simple-circuit/cocodvi/coco_dvi_sch.png

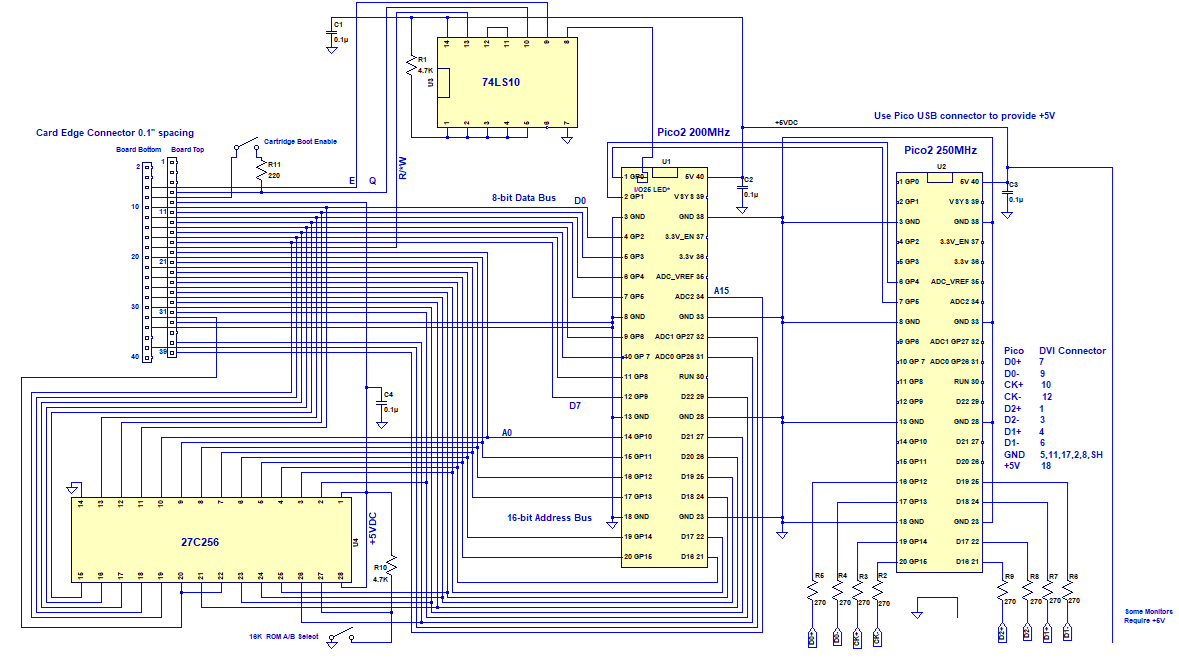
coco_dvi_sch.png
