simple-circuit/cocodvi/pico_hstx_coco_11/matrix.h

//matrix.h Simple-Circuit 2026

/*MIT License

matrix.h Copyright (c) 2026 simple-circuit

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
THE SOFTWARE IS PROVIDED "AS IS", WITHOUT WARRANTY OF ANY KIND, EXPRESS OR
IMPLIED, INCLUDING BUT NOT LIMITED TO THE WARRANTIES OF MERCHANTABILITY,
FITNESS FOR A PARTICULAR PURPOSE AND NONINFRINGEMENT. IN NO EVENT SHALL THE
AUTHORS OR COPYRIGHT HOLDERS BE LIABLE FOR ANY CLAIM, DAMAGES OR OTHER
LIABILITY, WHETHER IN AN ACTION OF CONTRACT, TORT OR OTHERWISE, ARISING FROM,
OUT OF OR IN CONNECTION WITH THE SOFTWARE OR THE USE OR OTHER DEALINGS IN THE
SOFTWARE.
*/ 
//128 ascii character matrix values for a 5x7 pixel display
// SPACE
bc[ 0x20] [ 2 ] = B0000000;
bc[ 0x20] [ 3 ] = B0000000;
bc[ 0x20] [ 4 ] = B0000000;
bc[ 0x20] [ 5 ] = B0000000;
bc[ 0x20] [ 6 ] = B0000000;
bc[ 0x20] [ 7 ] = B0000000;
bc[ 0x20] [ 8 ] = B0000000;
// !
bc[ 0x21] [ 2 ] = B0110000;
bc[ 0x21] [ 3 ] = B0110000;
bc[ 0x21] [ 4 ] = B0110000;
bc[ 0x21] [ 5 ] = B0110000;
bc[ 0x21] [ 6 ] = B0110000;
bc[ 0x21] [ 7 ] = B0000000;
bc[ 0x21] [ 8 ] = B0110000;
// "
bc[ 0x22] [ 2 ] = B0101000;
bc[ 0x22] [ 3 ] = B0101000;
bc[ 0x22] [ 4 ] = B0000000;
bc[ 0x22] [ 5 ] = B0000000;
bc[ 0x22] [ 6 ] = B0000000;
bc[ 0x22] [ 7 ] = B0000000;
bc[ 0x22] [ 8 ] = B0000000;
// #
bc[ 0x23] [ 2 ] = B0000000;
bc[ 0x23] [ 3 ] = B0101000;
bc[ 0x23] [ 4 ] = B1111100;
bc[ 0x23] [ 5 ] = B0101000;
bc[ 0x23] [ 6 ] = B1111100;
bc[ 0x23] [ 7 ] = B0101000;
bc[ 0x23] [ 8 ] = B0000000;
// $
bc[ 0x24] [ 2 ] = B0010000;
bc[ 0x24] [ 3 ] = B0111100;
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
bc[ 0x8f] [ 3 ] =  B11111111;
bc[ 0x8f] [ 4 ] =  B11111111;
bc[ 0x8f] [ 5 ] =  B11111111;
bc[ 0x8f] [ 6 ] =  B11111111;
bc[ 0x8f] [ 7 ] =  B11111111;
bc[ 0x8f] [ 8 ] =  B11111111;
bc[ 0x8f] [ 9 ] =  B11111111;
bc[ 0x8f] [ 10 ] = B11111111;
bc[ 0x8f] [ 11 ] = B11111111;
